emb3rcia/spark-rp2040-swd-probe/Schematic/spark-rp2040-swd-probe.pdf

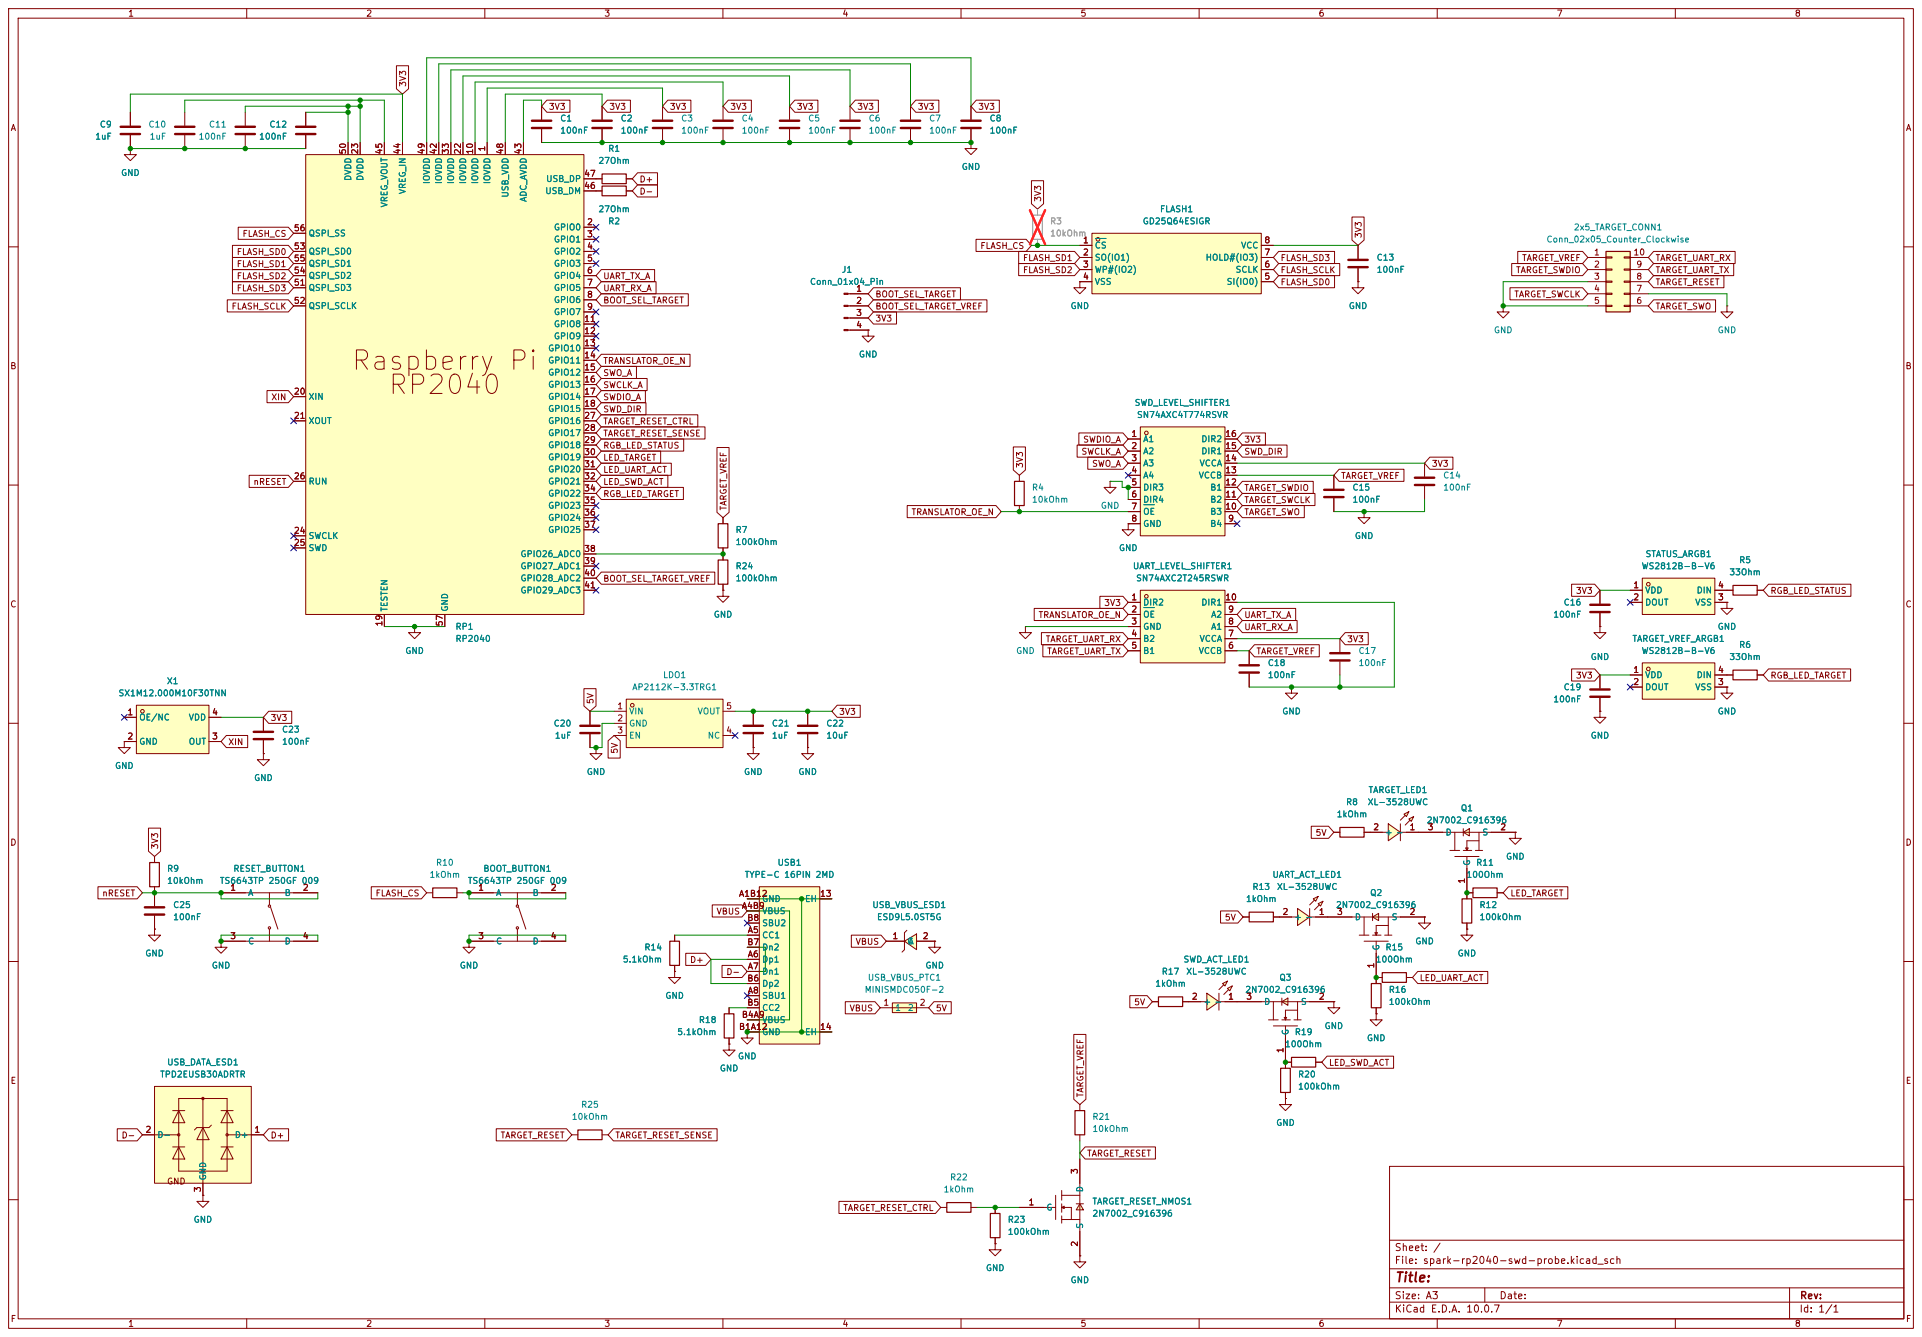
[picture p2: page 1]

Sheet: /
File: spark-rp2040-swd-probe.kicad_sch
Title:

Size: A3 | Rev: | F Date:
KiCad E.D.A. 10.0.7 | Id: 1/1
