emb3rcia/spark-rp2040-swd-probe/PCB/spark-rp2040-swd-probe.kicad_pcb

## KiCad design PCB/spark-rp2040-swd-probe.kicad_pcb (2026-10-15)

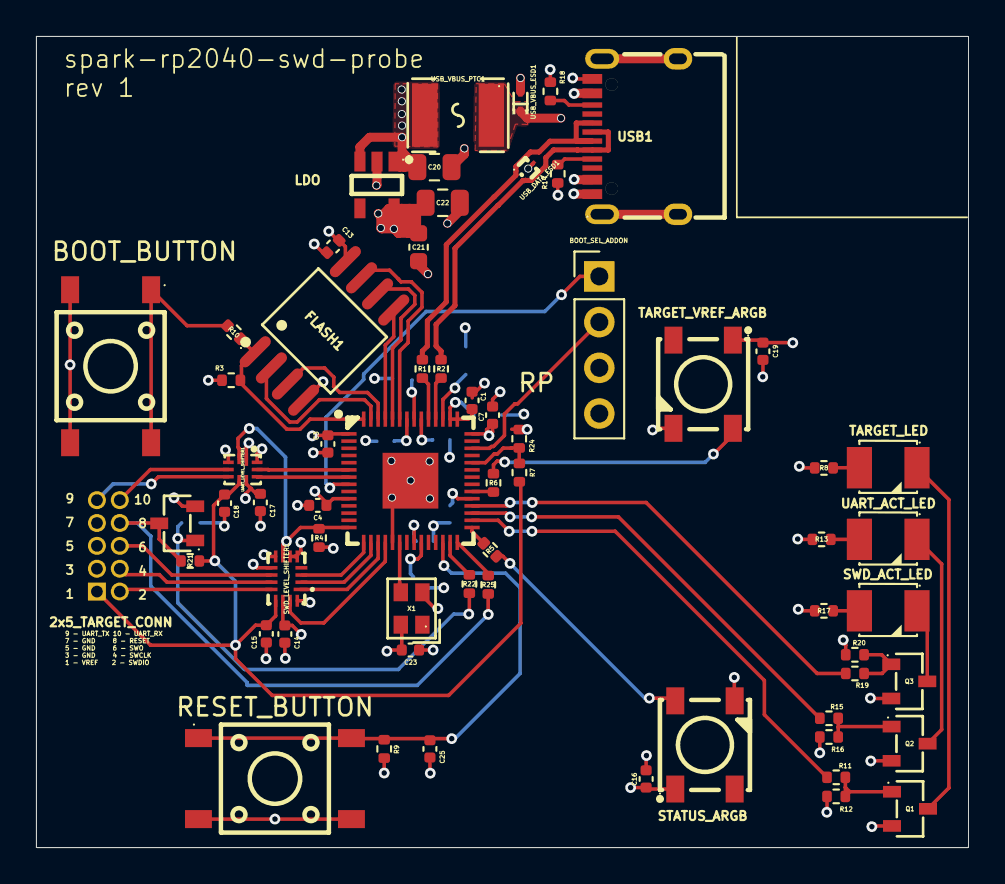
[picture p3: board spark-rp2040-swd-probe.kicad_pcb from above]

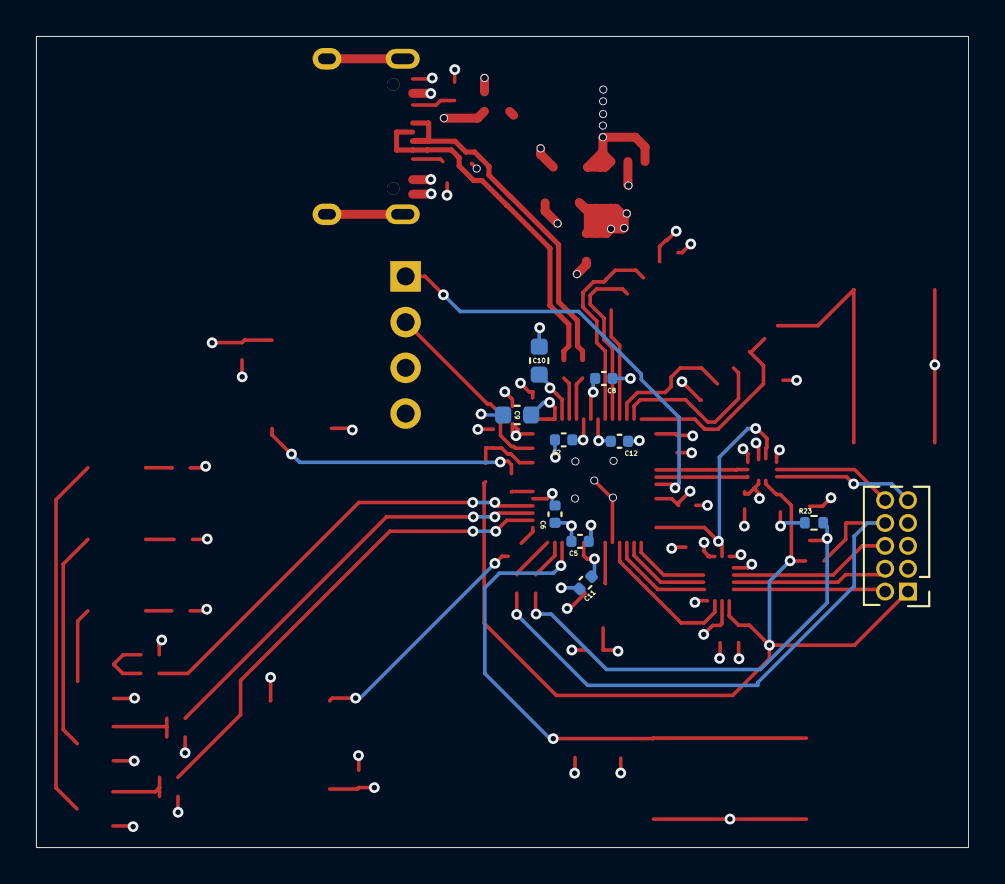
[picture p4: board spark-rp2040-swd-probe.kicad_pcb from below]

Board: 4 copper layers, 51.8 x 45.1 mm, 72 parts (10 on the bottom side), 56 nets.

Parts:
2x5_TARGET_CONN: Conn_02x05_Counter_Clockwise; PinHeader_2x05_P1.27mm_Vertical
BOOT_BUTTON: TS6643TP 250GF 009; SW-SMD_4P-L6.2-W6.0-P4.50-LS9.0
BOOT_SEL_ADDON: Conn_01x04_Pin; PinHeader_1x04_P2.54mm_Vertical
C1, C2, C3, C4, C5, C6, C7, C8, C11, C12, C13, C14, C15, C16, C17, C18, C19, C23, C25: 100nF; C_0402_1005Metric
C9, C10, C21: 1uF; C_0603_1608Metric
C20: 1uF; C_0805_2012Metric
C22: 10uF; C_0805_2012Metric
FLASH1: GD25Q64ESIGR; SOP-8_L5.3-W5.3-P1.27-LS7.9-BL
LDO: AP2112K-3.3TRG1; SOT-25-5_L2.9-W1.6-P0.95-LS2.8-BL
Q1, Q2, Q3: 2N7002_C916396; SOT-23-3_L2.9-W1.3-P1.90-LS2.4-BR
R1, R2: 27Ohm; R_0402_1005Metric
R3, R4, R9, R21, R25: 10kOhm; R_0402_1005Metric
R5, R6: 33Ohm; R_0402_1005Metric
R7, R12, R16, R20, R23, R24: 100kOhm; R_0402_1005Metric
R8, R10, R13, R17, R22: 1kOhm; R_0402_1005Metric
R11, R15, R19: 100Ohm; R_0402_1005Metric
R14, R18: 5.1kOhm; R_0402_1005Metric
RESET_BUTTON: TS6643TP 250GF 009; SW-SMD_4P-L6.2-W6.0-P4.50-LS9.0
RP: RP2040; LQFN-56_L7.0-W7.0-P0.4-EP
STATUS_ARGB: WS2812B-B-V6; LED-SMD_4P-L5.0-W5.0-TL_WS2812B-B
SWD_ACT_LED: XL-3528UWC; LED-SMD_L3.2-W2.8-LS3.5-XL-3528SURC
SWD_LEVEL_SHIFTER1: SN74AXC4T774RSVR; UQFN-16_L2.6-W1.8-P0.40-BL
TARGET_LED: XL-3528UWC; LED-SMD_L3.2-W2.8-LS3.5-XL-3528SURC
TARGET_RESET_NMOS1: 2N7002_C916396; SOT-23-3_L2.9-W1.3-P1.90-LS2.4-BR
TARGET_VREF_ARGB: WS2812B-B-V6; LED-SMD_4P-L5.0-W5.0-TL_WS2812B-B
UART_ACT_LED: XL-3528UWC; LED-SMD_L3.2-W2.8-LS3.5-XL-3528SURC
UART_LEVEL_SHIFTER1: SN74AXC2T245RSWR; UQFN-10_L1.8-W1.4-P0.40-TL
USB1: TYPE-C 16PIN 2MD; USB-C-SMD_TYPE-C-16PIN-2MD-073
USB_DATA_ESD1: TPD2EUSB30ADRTR; SOT-9X3-3_L1.0-W0.8-P0.35-LS1.0-BR
USB_VBUS_ESD1: ESD9L5.0ST5G; SOD-923_L0.8-W0.6-LS1.0-RD
USB_VBUS_PTC1: MINISMDC050F-2; F1812
X1: SX1M12.000M10F30TNN; OSC-SMD_4P-L2.0-W1.6-BL

Connections:
3V3: BOOT_SEL_ADDON.3, C1.1, C2.1, C3.1, C4.1, C5.1, C6.1, C7.1, C8.1, C9.1, C13.1, C14.1, C16.1, C17.1, C19.1, C21.1, C22.1, C23.1, FLASH1.8 (VCC), LDO.5 (VOUT), R3.1, R4.1, R9.1, RP.1 (IOVDD), RP.10 (IOVDD), RP.22 (IOVDD), RP.33 (IOVDD), RP.42 (IOVDD), RP.43 (ADC_AVDD), RP.44 (VREG_IN), RP.48 (USB_VDD), RP.49 (IOVDD), STATUS_ARGB.1 (VDD), SWD_LEVEL_SHIFTER1.14 (VCCA), SWD_LEVEL_SHIFTER1.16 (DIR2), TARGET_VREF_ARGB.1 (VDD), UART_LEVEL_SHIFTER1.1 (DIR2), UART_LEVEL_SHIFTER1.7 (VCCA), X1.4 (VDD)
5V: C20.1, LDO.1 (VIN), LDO.3 (EN), R8.1, R13.1, R17.1, USB_VBUS_PTC1.2
BOOT_SEL_TARGET: BOOT_SEL_ADDON.1, RP.8 (GPIO6)
BOOT_SEL_TARGET_VREF: BOOT_SEL_ADDON.2, RP.40 (GPIO28_ADC2)
D+: R1.2, USB1.A6 (Dp1), USB1.B6 (Dp2), USB_DATA_ESD1.1 (D+)
D-: R2.2, USB1.A7 (Dn1), USB1.B7 (Dn2), USB_DATA_ESD1.2 (D-)
FLASH_CS: FLASH1.1 (~CS), R3.2, R10.1, RP.56 (QSPI_SS)
FLASH_SCLK: FLASH1.6 (SCLK), RP.52 (QSPI_SCLK)
FLASH_SD0: FLASH1.5 (SI(IO0)), RP.53 (QSPI_SD0)
FLASH_SD1: FLASH1.2 (SO(IO1)), RP.55 (QSPI_SD1)
FLASH_SD2: FLASH1.3 (WP#(IO2)), RP.54 (QSPI_SD2)
FLASH_SD3: FLASH1.7 (HOLD#(IO3)), RP.51 (QSPI_SD3)
GND: 2x5_TARGET_CONN.3, 2x5_TARGET_CONN.5, 2x5_TARGET_CONN.7, BOOT_BUTTON.3 (C), BOOT_BUTTON.4 (D), BOOT_SEL_ADDON.4, C1.2, C2.2, C3.2, C4.2, C5.2, C6.2, C7.2, C8.2, C9.2, C10.2, C11.2, C12.2, C13.2, C14.2, C15.2, C16.2, C17.2, C18.2, C19.2, C20.2, C21.2, C22.2, C23.2, C25.2, FLASH1.4 (VSS), LDO.2 (GND), Q1.2 (S), Q2.2 (S), Q3.2 (S), R12.1, R14.2, R16.1, R18.2, R20.1, R23.1, R24.2, RESET_BUTTON.3 (C), RESET_BUTTON.4 (D), RP.19 (TESTEN), RP.57 (GND), STATUS_ARGB.3 (VSS), SWD_LEVEL_SHIFTER1.5 (DIR3), SWD_LEVEL_SHIFTER1.6 (DIR4), SWD_LEVEL_SHIFTER1.8 (GND), TARGET_RESET_NMOS1.2 (S), TARGET_VREF_ARGB.3 (VSS), UART_LEVEL_SHIFTER1.3 (GND), UART_LEVEL_SHIFTER1.10 (DIR1), USB1.13 (EH), USB1.14 (EH), USB1.A1B12 (GND), USB1.B1A12 (GND), USB_DATA_ESD1.3 (GND), USB_VBUS_ESD1.2 (A), X1.2 (GND)
LED_SWD_ACT: R19.2, RP.32 (GPIO21)
LED_TARGET: R11.2, RP.30 (GPIO19)
LED_UART_ACT: R15.2, RP.31 (GPIO20)
unnamed: BOOT_BUTTON.1 (A), BOOT_BUTTON.2 (B), R10.2
unnamed: Q1.3 (D), TARGET_LED.1 (-)
unnamed: Q1.1 (G), R11.1, R12.2
unnamed: Q2.3 (D), UART_ACT_LED.1 (-)
unnamed: Q2.1 (G), R15.1, R16.2
unnamed: Q3.3 (D), SWD_ACT_LED.1 (-)
unnamed: Q3.1 (G), R19.1, R20.2
unnamed: R7.2, R24.1, RP.38 (GPIO26_ADC0)
unnamed: R2.1, RP.46 (USB_DM)
unnamed: R1.1, RP.47 (USB_DP)
unnamed: C10.1, C11.1, C12.1, RP.23 (DVDD), RP.45 (VREG_VOUT), RP.50 (DVDD)
unnamed: R5.1, STATUS_ARGB.4 (DIN)
unnamed: R17.2, SWD_ACT_LED.2 (+)
unnamed: R8.2, TARGET_LED.2 (+)
unnamed: R22.2, R23.2, TARGET_RESET_NMOS1.1 (G)
unnamed: R6.1, TARGET_VREF_ARGB.4 (DIN)
unnamed: R13.2, UART_ACT_LED.2 (+)
unnamed: R14.1, USB1.A5 (CC1)
unnamed: R18.1, USB1.B5 (CC2)
RGB_LED_STATUS: R5.2, RP.29 (GPIO18)
RGB_LED_TARGET: R6.2, RP.34 (GPIO22)
SWCLK_A: RP.16 (GPIO13), SWD_LEVEL_SHIFTER1.2 (A2)
SWDIO_A: RP.17 (GPIO14), SWD_LEVEL_SHIFTER1.1 (A1)
SWD_DIR: RP.18 (GPIO15), SWD_LEVEL_SHIFTER1.15 (DIR1)
SWO_A: RP.15 (GPIO12), SWD_LEVEL_SHIFTER1.3 (A3)
TARGET_RESET: 2x5_TARGET_CONN.8, R21.2, R25.1, TARGET_RESET_NMOS1.3 (D)
TARGET_RESET_CTRL: R22.1, RP.27 (GPIO16)
TARGET_RESET_SENSE: R25.2, RP.28 (GPIO17)
TARGET_SWCLK: 2x5_TARGET_CONN.4, SWD_LEVEL_SHIFTER1.11 (B2)
TARGET_SWDIO: 2x5_TARGET_CONN.2, SWD_LEVEL_SHIFTER1.12 (B1)
TARGET_SWO: 2x5_TARGET_CONN.6, SWD_LEVEL_SHIFTER1.10 (B3)
TARGET_UART_RX: 2x5_TARGET_CONN.10, UART_LEVEL_SHIFTER1.4 (B2)
TARGET_UART_TX: 2x5_TARGET_CONN.9, UART_LEVEL_SHIFTER1.5 (B1)
TARGET_VREF: 2x5_TARGET_CONN.1, C15.1, C18.1, R7.1, R21.1, SWD_LEVEL_SHIFTER1.13 (VCCB), UART_LEVEL_SHIFTER1.6 (VCCB)
TRANSLATOR_OE_N: R4.2, RP.14 (GPIO11), SWD_LEVEL_SHIFTER1.7 (~OE), UART_LEVEL_SHIFTER1.2 (~OE)
UART_RX_A: RP.7 (GPIO5), UART_LEVEL_SHIFTER1.8 (A1)
UART_TX_A: RP.6 (GPIO4), UART_LEVEL_SHIFTER1.9 (A2)
VBUS: USB1.A4B9 (VBUS), USB1.B4A9 (VBUS), USB_VBUS_ESD1.1 (C), USB_VBUS_PTC1.1
XIN: RP.20 (XIN), X1.3 (OUT)
nRESET: C25.1, R9.2, RESET_BUTTON.1 (A), RESET_BUTTON.2 (B), RP.26 (RUN)
